aleistercrowleybeast666/SwiftTrust/Models/HARDWARE_REVIEW_v0.1.md

> 历史评审记录：本文中的旧ADC、时钟及引脚假设已由[2026-10-29双板硬件契约](REFERENCE_APPLICATION.md)替代；当前测试/交付见[R8硬件适配报告](R8_HARDWARE_ADAPTATION_20261029.md)。历史结果不代表当前固件或实板验证。

> 历史阶段记录。当前OLED/菜单/协议/实现状态以../HANDOFF.md、OLED_REFERENCE.md和../PROTOCOLS.md为准。

# SwiftThrust v0.1：画板前选型核查

状态：2026-10-19，候选设计，未绑定硬件。最新要求优先核查选型与 CubeMX，采集业务实现暂停。下列“匹配”只表示资源及已知条件匹配，不代表整机电路验证通过。

## MCU 与封装

| 用途 | 精确型号 | 已核对资源 | 结论 |
|---|---|---|---|
| 采集 | STM32F411RCT6 | LQFP64 10×10 mm；256 KiB Flash、128 KiB SRAM，最高100 MHz；有SDIO与SPI、DMA1/2 | 支持单卡SDIO四位与两条SPI候选分工；不是512 KiB Flash型号 |
| 遥控 | STM32G071KBT6 | **不带N的GP版本**，LQFP32 7×7 mm；128 KiB Flash、32 KiB带校验/36 KiB无校验SRAM，按32 KiB预算，最高64 MHz；SPI/I2C/TIM/ADC、DMA+DMAMUX | 当前功能资源匹配；没有SDIO，遥控端也不承担TF记录 |

依据：[ST F411精确料号](https://estore.st.com/en/stm32f411rct6-cpn.html)、[F411 DS10314 Rev8](https://www.st.com/resource/en/datasheet/stm32f411ce.pdf)、[G071精确料号](https://estore.st.com/en/stm32g071kbt6-cpn.html)、[G071 DS12232 Rev5，图5及订货信息](https://www.st.com/resource/en/datasheet/stm32g071kb.pdf)。并逐脚读取本机CubeMX官方器件XML交叉核对。

G071KBT6N也为LQFP32，但pin17的PB2变为PB15，pin26–29的PA15/PB3/PB4/PB5变为PD0/PD1/PD2/PD3。当前无线候选使用PA15、PB3–PB5，**不能替换为N版本**。BOM、原理图符号和采购完整料号必须一致。G071该32脚封装的电源是VDD/VDDA与VSS/VSSA共脚，不应凭大封装符号添加独立VBAT/VREF+脚；PF2-NRST、SWD和BOOT选项留原样，不操作选项字节。F411RCT6仅有VCAP1（pin30），不要套用其它F4的双VCAP符号；PB11未引出，不可分配。

## ADS131M02 与桥式传感器

ADS131M02IPWR为TSSOP-20候选。用户界面的“CH1推力”对应器件**CH0/AIN0P/N**，“CH2激励监测”对应器件CH1/AIN1P/N，避免编号错位。

高增益输入核查：芯片正常AVDD为2.7–3.6 V；2.5 V只是桥激励候选，**不能当作ADC模拟供电**。每个模拟输入在增益≥8时需满足 `AGND−1.3 V ≤ AIN ≤ AVDD−1.8 V`，增益≤4时上限为AVDD；同时差分幅度不得超过`±1.2 V/PGA`。这些是推荐工作范围，不是绝对最大额定值。

2.5 V对地桥激励且桥对称时，两个信号端约1.25 V共模。AVDD=3.0 V、高增益时输入上限只有1.2 V，**不匹配**；若稳定AVDD=3.3 V，则标称上限1.5 V，但必须以最低AVDD、激励误差、桥偏置、温漂、信号峰值和噪声再算余量。不能只凭“差分只有几mV”认定可用。

令传感器灵敏度为S mV/V，激励为E V，则额定信号为`S×E mV`；PGA须覆盖零偏、额定载荷、允许过载与标定方向，预留余量。示例仅说明公式：S=2、E=2.5时为5 mV，PGA128的差分满量程为9.375 mV，是否足够仍取决于真实传感器。尚未选择PGA或承诺有效分辨率；需检查输入阻抗对桥输出阻抗的负载误差、匹配RC、源阻抗、ESD/限流漏电以及低频漂移。差分ADC的24位输出不等于24位整机有效精度。

四线接口只含EXC±、SIG±；六线另有SENSE±。六线的远端激励补偿需实际布设高阻差分sense测量及/或稳压反馈，不能只换六针插座。四线可按电路明确在板端连接本地sense，但不能声称消除了电缆压降。ADC采用内部参考，没有可直接接桥激励的外部参考引脚；若CH2用于远端激励，软件比值换算仍需同步通道、各自PGA、分压比和标定，不能称硬件天然比率测量。

CH2不能将2.5 V直接相对地输入：PGA1差分满量程仅1.2 V。候选为独立低增益与差分衰减网络；最大分压比要满足`k×Emax < 1.2/PGA`并留裕量，同时逐端满足共模范围。电阻值、PGA、滤波/缓冲、sense接法、输入保护与四/六线切换方式尚未定。不要把远端SENSE−未经分析直接当作板上AGND。

以上条件来自[TI ADS131M02 SBAS853A RevA，6.3、8.3、8.5](https://www.ti.com/lit/ds/symlink/ads131m02.pdf)，数值例子是本项目推算。

## 数字接口与采样时基

ADC默认24位字长的常规NULL连续采样帧为4字：状态/前帧命令响应、CH0、CH1、输出CRC，共96 bit/12 byte。CRC覆盖前9字节；16位CRC位于末字最高16位，末字节填零。默认CCITT多项式0x1021，初值0xFFFF；另有ANSI配置，不能混用。状态原值应记录并检查RESET、F_RESYNC、REG_MAP、CRC_ERR、CRC_TYPE、WLENGTH及两路DRDY。16/32位字长和多寄存器命令不属于此12字节解析格式。

SPI为mode1（CPOL0/CPHA1）；CS覆盖完整帧。正常采样需要持续外部CLKIN，不能依赖仅用于特殊检测模式的内部振荡。`fMOD=fCLKIN/2`，普通连续转换时`fSPS=fCLKIN/(2×OSR)`，还必须匹配功耗模式与滤波配置。8.192 MHz/HR/OSR2048得到标称2kSPS是候选示例，未选振荡器或将此写成硬件配置。若MCU产生时钟，要验证可整除频率、占空比、抖动、启停与上电时序；PA8仅预留此选项，未启用MCO。上电或暂停后须按手册处理内部两深度FIFO和滤波稳定，不能把旧样本当新样本。

DRDY边沿捕获单调硬件时间并维护序号；DMA忙/队列满仍计数。扩展32位timer时须处理回绕及读取竞态；日志时间是DRDY参考时刻，不是模拟信号零延迟时刻，应记录滤波延迟。外部ADC无样本序号，长时间屏蔽中断会漏边沿，需同时检查时间间隔与ADC状态，不能承诺仅靠软件序号精确发现所有丢样。采样率要由CLKIN/OSR及实测连续时间戳核实，不能把任务延时或TF写入频率当作采样率。

[TI参考设计TIDUF72的采样与CRC实现说明](https://www.ti.com/lit/pdf/tiduf72)交叉支持12字节帧/9字节CRC覆盖。数字供电DVDD=3.3 V时ADC与3.3 V MCU逻辑兼容；不能把CAP数字LDO节点错误并接到3.3 V，更不能把5 V电平接入。

## E28与供电

亿佰特官方[E28-2G4M12XX英文手册，§2–4](https://www.cdebyte.com/pdf-down.aspx?id=2994)已在内存读取核对：SX1281 SPI模组，SX版本17.8×15 mm、IPEX；工作供电1.8–3.6 V、标称3.3 V，3.3 V通信电平；SPI最高10 Mbit/s。按手册预留MISO/MOSI/SCK/NSS、NRESET、BUSY和DIO1；DIO2/3不默认占用MCU管脚。NRESET低有效。当前候选IRQ使用DIO1，需后续驱动明确映射。

手册TX电流约45 mA为规划依据，不是整机最大电流。3.3 V电源要叠加TF写入峰值、MCU、ADC、OLED和桥激励负载；桥耗电约`E/Rbridge`，电阻值未给。射频模组远离ADC、时钟和开关节点，电源就近去耦，天线按所用IPEX方案及天线要求布置。旧2473MHz/+12dBm/SF10/BW812k/CR4/5与用户实测600/660m只存为历史；SF11/BW406k仍是候选，不写入默认发射配置，不宣称距离。

按常见4.2 V满充单锂方案推算，电池不能直供最大3.6 V的MCU/ADC/E28。仅3.3 V LDO或降压无法覆盖电池放电到低于稳压余量的全过程；是否升降压、何时欠压停止、模拟净化与功耗预算，要依据电芯和允许运行范围选择。2.5 V桥激励还需独立评估噪声、负载、启动和稳定度，不能凭稳压标称值定案。

充电输入、系统电源、电池、SWD调试供电、TF及传感器外来电源之间需核对反灌、电源关闭后的IO注入、掉电顺序和负载共享。充电器是否有power-path/反向阻断，必须看最终型号，不能从“带充电”推断具备。参考[TI单电池双电源应用SDAA050](https://www.ti.com/lit/pdf/sdaa050)讨论的路径与反向电流问题；本项目未选该文中的芯片。电芯保护、充电终止/温度、连接器额定能力和稳压热耗也待电路确认。

## 画板交接

优先保持ADC模拟信号与桥接口靠近，ADC数字接口朝向MCU；TF靠近PC8–PC12/PD2，无线靠近SPI2管脚。不要为了“分区”割断高速信号连续回流面；模拟低噪声供电与回流布局需随板层和器件布局审查。常规被动件优先现成0805封装，但ADC、MCU、TF座、IPEX和连接器按精确厂家封装，不能一概套0805。ERC要查每个电源/地/去耦、VCAP1、BOOT/NRST、SWD、SDIO上拉/电压、SPI电平、独立EXTI线和DMA复用。

板形、层数、充电/稳压芯片、激励电路、传感器规格、分压/保护和连接器待定。预留的点火PH2.0及未焊端子只记录需求；MOS/执行级/物理解除武装未定，不用GPIO下拉代替它们。本轮未配置点火管脚、驱动或命令。

补充核对：具体共模公式/页码、已收敛模拟供电候选、真实时钟状态、全速率缓冲预算和SDK体积见[FOLLOWUP_REVIEW_v0.1.md](FOLLOWUP_REVIEW_v0.1.md)。
