aleistercrowleybeast666/SwiftTrust/PROTOCOLS.md

# SwiftThrust R8 日志与无线协议入口

无线的完整帧格式、身份、会话、事务、菜单及全部收发流程见 [R8协议](Models/LORA_PROTOCOL_R8.md)。R7旧无线格式不再接收，必须两端同时升级。原NV分区与STLOG001布局保留。

## 2. TF日志：STLOG001

### 2.1 文件组成与CRC

文件为`512B头 + N×32B样本 + 32B结束记录`，干净停止后执行sync和close。文件头一次写入，不在结束时回写。

文件头和每条记录各用CRC32/IEEE：反射多项式0xEDB88320、init=0xFFFFFFFF、xorout=0xFFFFFFFF。校验值自身按小端存储；测试向量ASCII `123456789`结果为0xCBF43926。

### 2.2 512B文件头

| 偏移 | 长度 | 类型 | 内容及单位 |
|---:|---:|---|---|
| 0 | 8 | ASCII | `STLOG001`，含格式版本标识 |
| 8 | 2 | u16 | 文件头长度，固定512B |
| 10 | 2 | u16 | 记录长度，固定32B |
| 12 | 4 | u32 | ADC CLKIN配置频率，Hz |
| 16 | 4 | u32 | 历史ADC的OSR；ADS1220不适用，写0并使用ADC1扩展 |
| 20 | 4 | u32 | 理论有效采样率mHz；ADS1220当前为1976834，区别于标称2000000 |
| 24 | 4 | u32 | boot_epoch，启动代号；**不是Unix时间** |
| 28 | 4 | u32 | 标定profile_id，0表示未指定 |
| 32 | 4 | u32 | 标定profile_version |
| 36 | 4 | i32 | 推力通道零点原始码，count |
| 40 | 8 | i64 | 推力换算斜率，nN/count |
| 48 | 8 | i64 | 历史监测通道换算斜率nV/count；ADS1220无第二通道，固定0 |
| 56 | 1 | u8 | 芯片CH0 PGA倍数，例如1/2/4…128 |
| 57 | 1 | u8 | 历史CH1 PGA倍数；ADS1220固定0，表示不存在 |
| 58 | 1 | u8 | 传感器线数，已标定时应为4或6，未指定可0 |
| 59 | 1 | 位标志 | bit0：标定有效；bit1：合成测试数据；其余保留0 |
| 60 | 24 | 兼容扩展 | 无会话置零时为0；有效时SZR1@60、永久zero:i32@64、会话zero:i32@68、samples:u32@72、time_us:u64@76 |
| 84 | 44 | 兼容扩展 | ADC1元数据，见下表；历史ADS131M02日志为全0 |
| 128 | 380 | 保留 | 固定0 |
| 508 | 4 | u32 | 头CRC32，覆盖偏移0…507 |

| 偏移 | 类型 | ADC1内容 |
|---:|---|---|
| 84 / 88 / 90 | ASCII4 / u16 / u16 | `ADC1` / 版本1 / 扩展长度44 |
| 92 / 94 / 95 | u16 / u8 / u8 | ADC型号1220 / 通道数1 / 原始位数24 |
| 96 / 100 | u32 / u32 | 参考电压µV=5000000 / 标称速率mHz=2000000 |
| 104 / 108 | u32 / u32 | 连续转换周期2072个CLK / START前实测DRDY速率mHz；未测为0 |
| 112 / 113 / 114 | u8 / u8 / u8 | MUX=3(AIN1-AIN2) / Turbo模式=2 / PGA bypass=0或1 |
| 115 / 116 / 117 | u8 / u8 / u8 | 正输入AIN1 / 负输入AIN2 / 1=有符号二进制补码 |
| 118 / 119 | u8 / u8 | 0=无硬件状态字 / 保留0 |
| 120 / 124 | u32 / u32 | 激励标称µV=5000000 / bit0时钟已核对、bit1实测速率有效 |

4.096MHz外部CLK下，Turbo DR=110连续转换周期为2072CLK，即505.859375µs、1976.8339768SPS；首转换另有114CLK启动延迟。依据[TI ADS1220数据手册表8-4](https://www.ti.com/lit/ds/symlink/ads1220.pdf)。头中的实测速率来自DRDY时间戳统计，不是写卡速率；导出报告另外计算保存记录速率、有效记录速率及序号/时间戳推算的转换速率（含估计缺失转换数，不等于实际中断边沿计数）。输入范围和灵敏度完整配置保存在SENSOR.CFG并通过config_id绑定标定，激励/参考字段是配置标称值，未宣称实测。

### 2.3 每条样本32B

| 偏移 | 长度 | 类型 | 内容及单位 |
|---:|---:|---|---|
| 0 | 4 | u32 | DRDY序号；源序号在DMA忙/丢样时也应前进 |
| 4 | 8 | u64 | DRDY边沿单调时间，µs；不是写卡/无线完成时间 |
| 12 | 4 | i32 | 原始CH0码，24位符号扩展，count |
| 16 | 4 | i32 | 历史原始CH1；ADC1单通道日志固定INT32_MIN，明确表示不存在，不是第二路零读数 |
| 20 | 2 | u16 | 历史ADS131M02状态字；ADS1220无状态字，固定0，导出为空 |
| 22 | 2 | 位标志 | 样本质量flags，见下表 |
| 24 | 4 | u32 | 此样本前检测到的缺样数量；无法有序判断时0xFFFFFFFF |
| 28 | 4 | u32 | 记录CRC32，覆盖本条偏移0…27 |

| flags位 | 含义 |
|---:|---|
| 0 | 历史ADC输出CRC错误；ADS1220不产生此标志 |
| 1 | 捕获缓冲补位格式错误；ADS1220只有3B原始码，其余缓冲字节须0 |
| 2 | 历史ADC状态故障；ADS1220传输错误由源错误统计及停止流程报告 |
| 3 | 原始通道达到24位正/负极值，疑似饱和 |
| 4 | 序号不连续 |
| 5 | 时间戳未严格递增 |
| 6…14 | 当前保留0 |
| 15 | 结束记录标识；普通样本为0 |

时间轴使用独立TIM5微秒时钟，尚未实现UTC同步。原始码范围-8388608…8388607。ADS1220没有SPI输出CRC，文件CRC仅验证落盘内容完整性，不能检测所有SPI线上位翻转或证明传感器接线正常。DMA失败/超时不生成虚构样本；源序号间隙及结束错误统计保留丢样事实。

### 2.4 标定与CSV

标定有效时：`force_N = (raw_CH0 - zero_raw) × slope_nN_per_count / 10^9`。

ADS1220输入差分电压为`raw_CH0 × reference_uv / (8388608 × PGA_gain × 10^6)`伏；采用5V同源激励/参考实现比例式测量。没有有效标定时仅提供原始码与电压，推力列为空。历史双通道日志仍按原元数据导出CH1；新日志CH1列为空。

当前CSV导出只有在profile/版本/线数/系数和标定有效标志完整，且样本flags的bit0…3均为0时才给出推力N；未知或故障时留空。监测比例为0时监测V留空。缺样/时间标志仍随行输出。电压档位不是精确SOC。

### 2.5 结束记录与损坏恢复

最后一条的flags固定0x8000；偏移0/4为最后样本序号/时间，偏移12改作**u32环形队列丢弃总数**，偏移16改作**u32 ADC完整性及源DMA错误总数**，其余保留0，仍有同样的CRC32。无样本时序号/时间可0，不能据此当作已有有效采样。

导出工具先验头CRC，再按顺序验记录CRC；遇到坏记录即停止并报告问题，断尾保留完整前缀。完整尾记录且没有多余或坏字节时报告clean_close。sync成功与写入完成分开记录，但这不能保证SD卡内部缓存和FAT目录突然断电绝对安全。

命令：`python -B Models/export_stlog.py input.BIN output.csv`。CSV排他新建，已有同名文件不覆盖。它是通用CSV，**尚未验证UNDERLINE专用导入兼容**。

## 无线实现

唯一R8基础编解码位于 `Acquisition/src/st_frame.c`，会话和普通事务位于 `st_link2.c`；输出策略复用该基础帧和事务ID，保留独立准入、限时授权、一次发送及结果查询。

R1参考格式的 `st_protocol.c` 只用于旧Host兼容回归，ReferenceApp接收路径仅接受R8。

旧R7无线规范见 [历史资料](Models/LORA_PROTOCOL.md)，不适用于当前固件。
