aleistercrowleybeast666/SwiftTrust/STATUS_v0.1.md

# 当前状态索引

文件名沿用初期名称；最新软件、两端组件链接及未完成板级事项请见[HANDOFF](HANDOFF.md)、[协议](PROTOCOLS.md)、[验证说明](Models/VALIDATION.md)。旧阶段报告均为历史证据，不代表整板已验收。
