aleistercrowleybeast666/SwiftTrust/Models/STLOG_FORMAT.md

# STLOG001日志格式

规范已整合至项目根目录 [PROTOCOLS.md](../PROTOCOLS.md)，以该统一文档为准。本文件仅保留旧链接入口，不维护重复字段表。
