aleistercrowleybeast666/SwiftTrust/Models/ignition_ui_preview.png

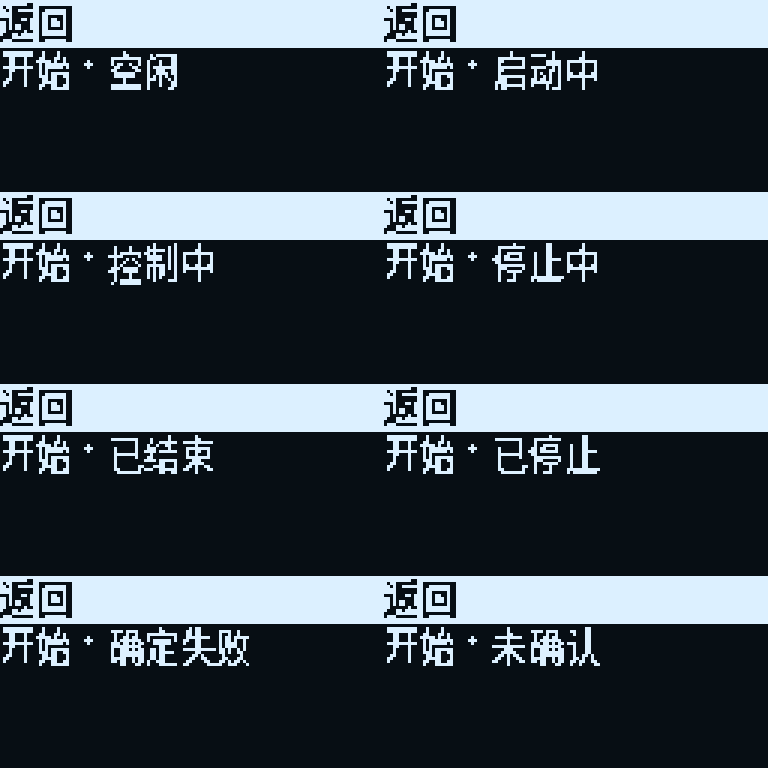
Models/ignition_ui_preview.png
