aleistercrowleybeast666/SwiftTrust/Models/ignition_ui_preview_en.png

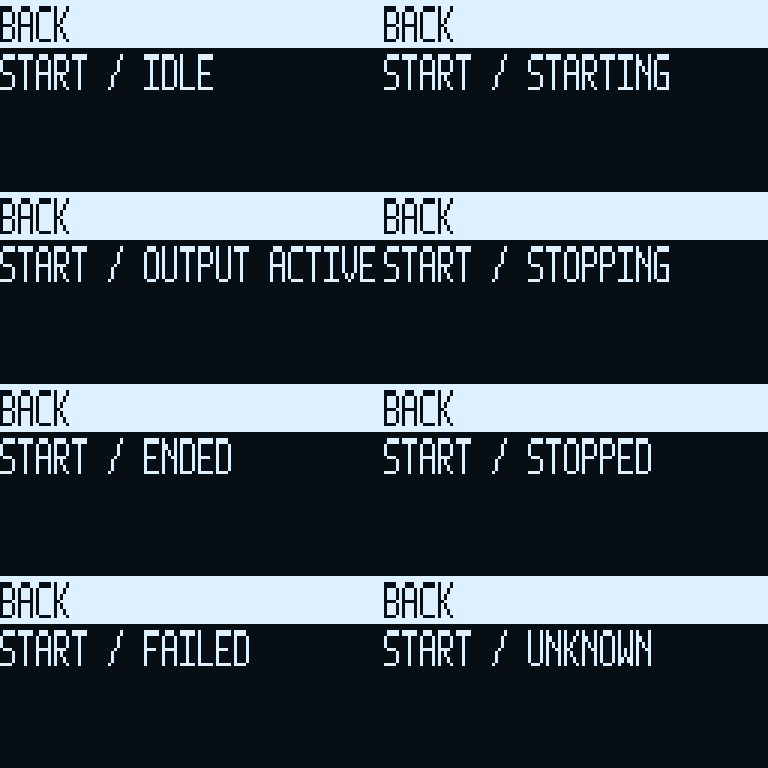
Models/ignition_ui_preview_en.png
