aleistercrowleybeast666/SwiftTrust/Models/ui_host_preview.png

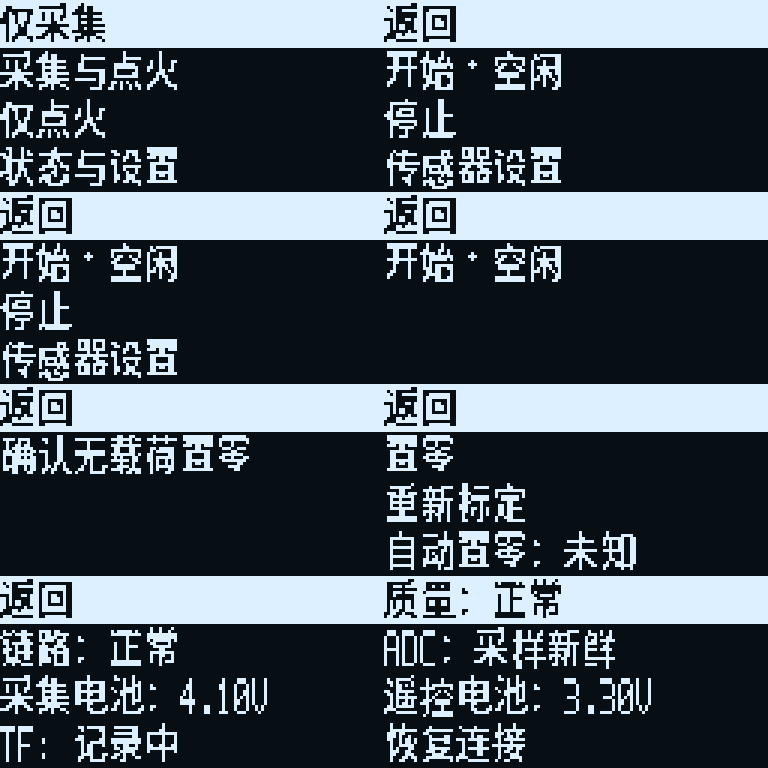
Models/ui_host_preview.png
