aleistercrowleybeast666/SwiftTrust/Models/ui_host_preview_en.png

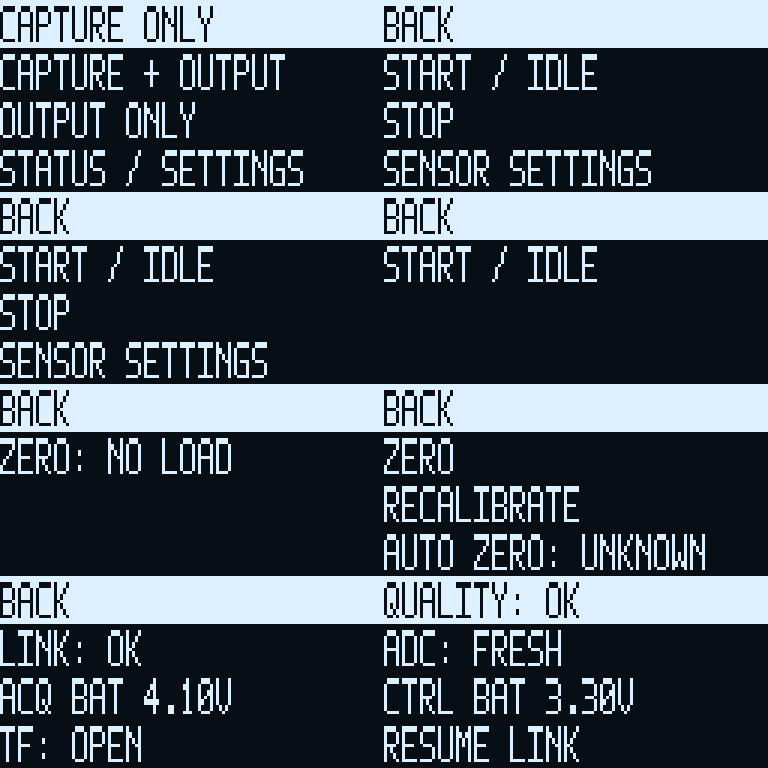
Models/ui_host_preview_en.png
