aleistercrowleybeast666/SwiftTrust/Models/CALIBRATION.md

# R8 ADS1220标定与兼容策略

当前可运行入口为两端ReferenceApp。采集板使用ADS1220，只有AIN1-AIN2一路差分桥式输入，外部参考与桥激励均为标称5V。旧ADS131M02标定不能用于当前ADC；没有有效传感器配置或标定时仍允许记录真实原始码，推力保持无效。

## 传感器配置

TF根目录SENSOR.CFG沿用显式ACK、PROFILE_ID、SENSOR_ID、WIRE_COUNT、RATED_FORCE_MN、EXCITATION_UV、MAX_SPAN_COUNTS、MIN_DELTA_COUNTS及可选AUTO_ZERO。新增必填PGA_GAIN、PGA_BYPASS、SENSITIVITY_NV_V、COMMON_MODE_MIN_UV、COMMON_MODE_MAX_UV。2mV/V填写2000000nV/V；满量程输入µV=激励µV×灵敏度nV/V÷10^9，向上取整后检验PGA满量程及输入共模限制。

ADC初始化采用经检查的配置。PGA只能1/2/4/8/16/32/64/128，bypass仅允许1/2/4。启用PGA时按TI共模/输出摆幅限制检查整个声明输入范围；不接受任意传感器默认PGA128。未知传感器采用PGA1、bypass的原始记录配置，不代表已经验证传感器兼容性。例文件的零值故意使标定无效，必须按真实传感器填写。

配置绑定包含ADC型号、外部参考、输入MUX、PGA与bypass、Turbo模式、ADC时钟、理论有效速率、激励、传感器ID、额定力、线数及配置指纹。指纹按规范整数值生成，包含灵敏度、共模范围及稳定阈值；不因文件空白或临时AUTO_ZERO改变。未知、重复、缺失、溢出和错误字段拒绝配置。

## 原始码与力值

ADS1220输入电压`Vdiff = raw × 5 / (8388608 × PGA)`伏。AIN1为正输入，AIN2为负输入；允许通过已知载荷标定得到负斜率，不能强行翻转原始码。外部参考和桥激励同源，标称值不冒充实时电压测量。

永久空载均值r0和加载均值r1只由只读原始窗口统计；`k=round(Fref_nN/(r1-r0))`，以有符号nN/count保存。推力为`(raw-r0)×k/10^9`N，窗口过程从不修改原始码或日志记录。参考质量以显式g/kg及保存的重力换算，N直接输入。0系数、越界参考力、饱和、SPI/源错误、队列溢出、缺样、非递增时间、噪声超限和超时拒绝候选。

## 菜单与会话置零

保留四行菜单、旋转选择、短按确认、载荷编辑、审阅、保存和取消。永久空载和加载窗口完成后，只有SAVE完成真实文件sync、close及逐字节读回才替换活动参数；无线接收ACK不等于保存完成。SAVE回复丢失显示结果未确认，通过后续查询核对，不谎报旧值必定保留。

本次会话置零保持独立，默认关闭、可配置自动置零。它使用稳定窗口覆盖本次日志的零点，保留永久零点和斜率；SZR1扩展同时记录永久零点、会话零点、样本数及时间。重新开始且关闭会话置零时恢复永久零点。运行中不更改标定。

## CAL0.BIN / CAL1.BIN迁移

两个固定1KiB文件保留STCS0001/STCC0001封装、64位代号、CRC、256B STCAL001和提交封记。新STCAL001仅在原保留区域增加ADC1扩展：176处magic、180处u16型号1220、182处MUX、183处bypass、184处u32参考µV、188处u32扩展版本1；192..251仍为0，252处CRC32。历史全零扩展可解析为旧ADS131M02，不能与新绑定相等。

检测到完整有效但绑定不同的ADC/传感器/增益文件，且其代号高于任何匹配文件时返回ST_CAL_DISK_MIGRATION，活动标定无效、原始采集仍可用，并允许用户完成新标定。新SAVE写入另一个槽，代号高于最高旧代号，revision从1开始，按数据→sync→封记→sync→close→重新打开读回的原流程提交；最高代号旧文件在新提交前不被覆盖。重启后优先选择更高代号、绑定匹配的新文件。相同代号冲突仍报故障。不同传感器/PGA配置不自动应用、也不自动覆盖；仅明确完成的新标定可保存。较新异绑定文件存在时不会回退使用较旧匹配系数。不擦除配对NV、不重置会话序号。

已损坏新槽与有效旧槽共存时仍可重新完成迁移。两槽均损坏或发生I/O错误时保留明确故障，不格式化。FAT元数据、卡FTL与掉电不由双文件机制绝对保证；需实物断电测试。

## 调度与验证边界

DRDY/DMA中断只投递带时间戳的原始码及错误，标定计算和FatFs位于唯一前台owner。标定tap为64项独立队列，队列溢出和DMA错误拒绝候选。日志仍为512B头、32B记录；ADC1元数据及旧日志读取见[日志规范](../PROTOCOLS.md)。

离线回归覆盖正负标定、原始码不变、ADC配置/参考绑定失配、旧格式解析但不应用、迁移后新系数保存/读回、双槽每扇区错误/撕裂、取消、会话置零、R8重试和菜单。实际加载/卸载、多点线性、噪声、共模、电源比例误差及动态响应仍须实物验证，主机模拟不代表已完成校准。
