aleistercrowleybeast666/SwiftTrust/Models/calibration_ui_preview.png

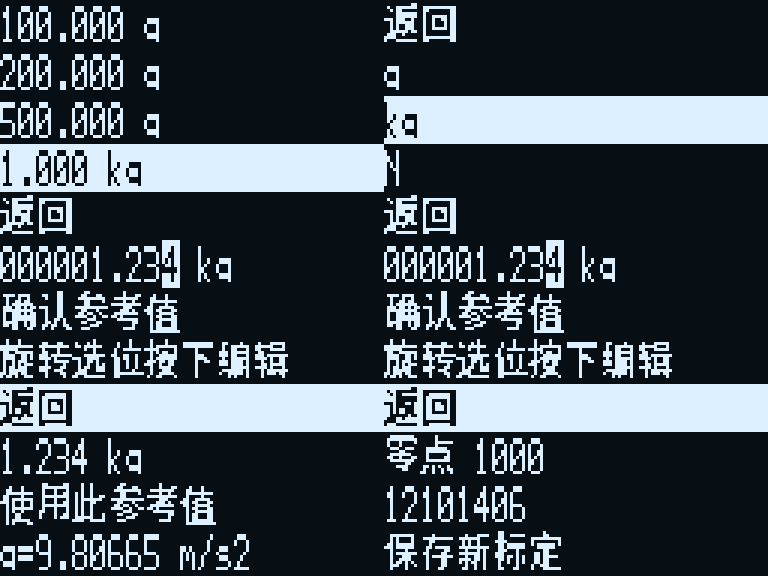
Models/calibration_ui_preview.png
