aleistercrowleybeast666/SwiftTrust/Models/calibration_ui_preview_en.png

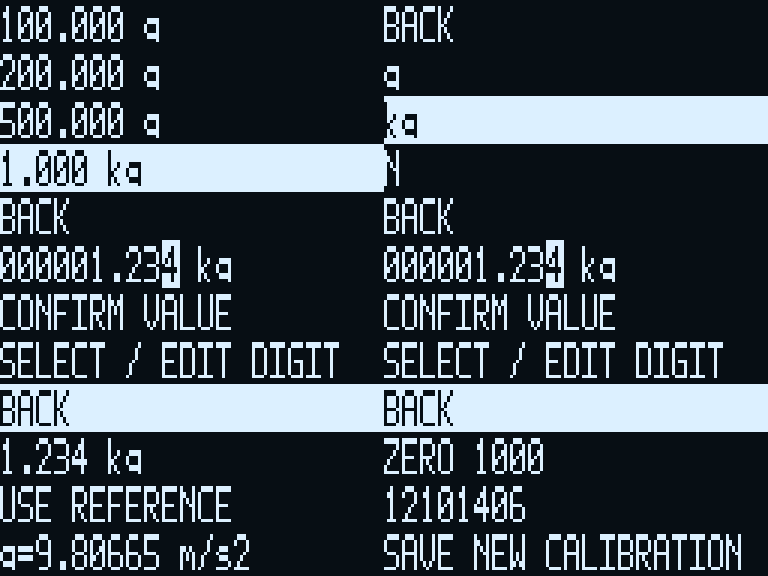
Models/calibration_ui_preview_en.png
