aleistercrowleybeast666/SwiftTrust/Acquisition/SwiftThrust_Acquisition_Candidate/SwiftThrust_Acquisition_Candidate.ioc

Mcu.UserName=STM32F411RCTx
PA0-WKUP.GPIO_Label=CAND_IGNITION_SIGNAL
PA0-WKUP.Signal=S_TIM2_CH1_ETR
PA13.GPIO_Label=CAND_SWDIO
PA13.Signal=SYS_JTMS-SWDIO
PA14.GPIO_Label=CAND_SWCLK
PA14.Signal=SYS_JTCK-SWCLK
PA15.GPIO_Label=CAND_ADC_DRDY
PA15.Signal=GPXTI15
PA2.GPIO_Label=CAND_DEBUG_UART_TX
PA2.Signal=USART2_TX
PA3.GPIO_Label=CAND_DEBUG_UART_RX
PA3.Signal=USART2_RX
PA4.GPIO_Label=CAND_LED_VOLT_1
PA4.Signal=GPIO_Output
PA5.GPIO_Label=CAND_LED_VOLT_2
PA5.Signal=GPIO_Output
PA6.GPIO_Label=CAND_LED_VOLT_3
PA6.Signal=GPIO_Output
PA7.GPIO_Label=CAND_LED_VOLT_4
PA7.Signal=GPIO_Output
PA8.GPIO_Label=CAND_ADC_CLK
PA8.Signal=RCC_MCO_1
PA9.GPIO_Label=CAND_TF_CARD_DETECT
PA9.Signal=GPIO_Input
PB10.GPIO_Label=CAND_LINK_LED
PB10.Signal=GPIO_Output
PB12.GPIO_Label=CAND_RADIO_CS
PB12.Signal=GPIO_Output
PB13.GPIO_Label=CAND_RADIO_SCK
PB13.Signal=SPI2_SCK
PB14.GPIO_Label=CAND_RADIO_MISO
PB14.Signal=SPI2_MISO
PB15.GPIO_Label=CAND_RADIO_MOSI
PB15.Signal=SPI2_MOSI
PB2.GPIO_Label=CAND_RADIO_NRESET
PB2.Signal=GPIO_Output
PB3.GPIO_Label=CAND_ADC_SCK
PB3.Signal=SPI1_SCK
PB4.GPIO_Label=CAND_ADC_DOUT
PB4.Signal=SPI1_MISO
PB5.GPIO_Label=CAND_ADC_DIN
PB5.Signal=SPI1_MOSI
PB6.GPIO_Label=CAND_ADC_CS
PB6.Signal=GPIO_Output
PC0.GPIO_Label=CAND_ACQUISITION_BATTERY
PC0.Signal=ADCx_IN10
PC10.GPIO_Label=CAND_TF_D2
PC10.Signal=SDIO_D2
PC11.GPIO_Label=CAND_TF_D3
PC11.Signal=SDIO_D3
PC12.GPIO_Label=CAND_TF_CLK
PC12.Signal=SDIO_CK
PC6.GPIO_Label=CAND_RADIO_BUSY
PC6.Signal=GPIO_Input
PC7.GPIO_Label=CAND_RADIO_DIO1
PC7.Signal=GPXTI7
PC8.GPIO_Label=CAND_TF_D0
PC8.Signal=SDIO_D0
PC9.GPIO_Label=CAND_TF_D1
PC9.Signal=SDIO_D1
PD2.GPIO_Label=CAND_TF_CMD
PD2.Signal=SDIO_CMD
