aleistercrowleybeast666/SwiftTrust/Models/validate_candidates.py

"""Offline resource/analog math regression. Not a firmware, timing or hardware test."""
import csv
import os
import io
import json
import re
import subprocess
import sys
import unittest
from unittest.mock import patch
import xml.etree.ElementTree as ET
from pathlib import Path

ROOT = Path(__file__).resolve().parents[1]
DB = Path(os.environ.get("CUBEMX_ROOT",r"C:\Program Files\STMicroelectronics\STM32Cube\STM32CubeMX"))/"db/mcu"
NS = {"m": "http://mcd.rou.st.com/modules.php?name=mcu"}
PARTS = {
    "Acquisition": ("STM32F411RCT6", "STM32F411R(C-E)Tx.xml", "LQFP64"),
    "Controller": ("STM32G071KBT6", "STM32G071K(6-8-B)Tx.xml", "LQFP32"),
}
ACQUISITION_PIN_ASSIGNMENT = {
    "ADC_SCK": ("PB3", "55", "SPI1_SCK"),
    "ADC_DOUT": ("PB4", "56", "SPI1_MISO"),
    "ADC_DIN": ("PB5", "57", "SPI1_MOSI"),
    "ADC_CS": ("PB6", "58", "GPIO_Output"),
    "ADC_DRDY": ("PA15", "50", "GPIO_EXTI15"),
    "LED_VOLT_1": ("PA4", "20", "GPIO_Output"),
    "LED_VOLT_2": ("PA5", "21", "GPIO_Output"),
    "LED_VOLT_3": ("PA6", "22", "GPIO_Output"),
    "LED_VOLT_4": ("PA7", "23", "GPIO_Output"),
    "TF_CARD_DETECT": ("PA9", "42", "GPIO_Input"),
    "DEBUG_UART_TX": ("PA2", "16", "USART2_TX"),
    "DEBUG_UART_RX": ("PA3", "17", "USART2_RX"),
}


def read_csv(path):
    with path.open(encoding="utf-8", newline="") as handle:
        return list(csv.DictReader(handle))


def pin_db(filename):
    root = ET.parse(DB / filename).getroot()
    return {p.get("Name"): (p.get("Position"), {s.get("Name") for s in p.findall("m:Signal", NS)})
            for p in root.findall("m:Pin", NS)}


def gpio_af_db(filename="GPIO-STM32F411_gpio_v1_0_Modes.xml"):
    root = ET.parse(DB / "IP" / filename).getroot()
    return {(pin.get("Name"), signal.get("Name")): {
                value.text for value in signal.findall(
                    "m:SpecificParameter[@Name='GPIO_AF']/m:PossibleValue", NS)}
            for pin in root.findall("m:GPIO_Pin", NS)
            for signal in pin.findall("m:PinSignal", NS)}


def usart_async_defaults():
    # CubeMX omits parameters set to their defaults when saving the IOC.
    root = ET.parse(DB / "IP/USART-sci2_v1_2_Cube_Modes.xml").getroot()
    fields = {"BaudRate", "WordLength", "StopBits", "Parity"}
    return {param.get("Name"): param.get("DefaultValue")
            for param in root.findall("m:RefParameter", NS)
            if param.get("Name") in fields and param.find("m:Condition", NS) is None}


def validate_acquisition_assignment(rows):
    # Explicit user assignment takes precedence over the still-old CAD export.
    by_role = {row["role"]: row for row in rows}
    for role, expected in ACQUISITION_PIN_ASSIGNMENT.items():
        row = by_role.get(role, {})
        actual = tuple(row.get(key) for key in ("pin", "package_position", "signal"))
        if actual != expected:
            raise ValueError("Acquisition 2026-11-01 pin assignment mismatch: " + role)


def validate_pins(rows, pins):
    seen_positions, seen_exti = set(), set()
    for row in rows:
        pin, signal = row["pin"], row["signal"]
        if pin not in pins:
            raise ValueError(f"Pin not present in exact package: {pin}")
        position, signals = pins[pin]
        if str(position) != row["package_position"]:
            raise ValueError(f"Physical pin mismatch: {pin}")
        if position in seen_positions:
            raise ValueError(f"Duplicate physical position: {position}")
        seen_positions.add(position)
        if signal == "RESERVED":
            continue
        if signal.startswith("GPIO_") or signal.startswith("GPXTI"):
            if "GPIO" not in signals:
                raise ValueError(f"GPIO unavailable: {pin}")
        elif signal not in signals:
            raise ValueError(f"Alternate function unavailable: {pin}/{signal}")
        if signal.startswith(("GPXTI", "GPIO_EXTI")):
            exti = int(re.search(r"\d+$", signal).group())
            if int(re.search(r"\d+", pin).group()) != exti or exti in seen_exti:
                raise ValueError("Invalid or conflicting EXTI line")
            seen_exti.add(exti)


def dma_db():
    root = ET.parse(DB / "IP/DMA-STM32F411_dma_v2_0_Modes.xml").getroot()
    streams, channels = {}, {}
    for e in root.iter():
        tag, name = e.tag.split("}")[-1], e.get("Name", "")
        if tag == "Mode" and re.fullmatch(r"DMA[12]_Stream\d", name):
            streams[name] = {m.get("Name") for m in e.iter() if m.tag.split("}")[-1] == "Mode"}
        if tag == "RefMode":
            values = set()
            for param in e:
                if param.get("Name") == "Channel":
                    values.update(p.text for p in param if p.text)
            if values:
                channels[name] = values
    return streams, channels


def validate_dma(rows, mapping):
    streams, channels = mapping
    used = set()
    for row in rows:
        stream = f'{row["controller"]}_Stream{row["stream"]}'
        mode = row["mode_name"]
        if stream in used:
            raise ValueError("Exclusive DMA stream conflict")
        used.add(stream)
        if mode not in streams.get(stream, set()):
            raise ValueError(f"DMA request not mapped: {stream}/{mode}")
        if f'DMA_CHANNEL_{row["channel"]}' not in channels.get(mode, set()):
            raise ValueError(f"Wrong DMA channel: {mode}")


def read_ioc(path):
    # CubeMX writes Java-property escaped spaces in remapped G0 pin keys.
    return {key.replace("\\ ", " "): value for key, value in
            (line.split("=", 1) for line in path.read_text(encoding="utf-8").splitlines()
             if "=" in line and not line.startswith("#"))}


def validate_ioc(board, rows):
    part, _, package = PARTS[board]
    path = ROOT / board / f"SwiftThrust_{board}_Candidate" / f"SwiftThrust_{board}_Candidate.ioc"
    values = read_ioc(path)
    if values.get("Mcu.CPN") != part or values.get("Mcu.Package") != package:
        raise ValueError(f"{board}: wrong exact device or package")
    constants = dict(item.split(",", 1) for item in values.get("Mcu.UserConstants", "").split(";") if "," in item)
    if constants.get("SWIFTTHRUST_BOARD_BOUND") not in ("0", "1"):
        raise ValueError("Board CAD binding annotation missing")
    if board == "Acquisition":
        expected_constants = {"SWIFTTHRUST_ADC_AVDD_MV_CANDIDATE": "5000", "SWIFTTHRUST_ADC_DVDD_MV_CANDIDATE": "3300", "SWIFTTHRUST_BRIDGE_EXC_MV_CANDIDATE": "5000"}
        if any(constants.get(k) != v for k, v in expected_constants.items()):
            raise ValueError("Analog candidate annotations not saved in CubeMX")
    for row in rows:
        signal, pin = row["signal"], row["pin"]
        actual = values.get(f"{pin}.Signal")
        if signal == "RESERVED":
            if actual:
                raise ValueError(f"Reserved pin unexpectedly enabled: {pin}/{actual}")
            continue
        # CubeMX may emit shared ADCx/TIM signals with an explicit SH mapping.
        shared = any(k.startswith(f"SH.{actual}.") and (v == signal or v.startswith(signal + ","))
                     for k, v in values.items()) if actual else False
        if actual != signal and not shared:
            raise ValueError(f"{board}: saved .ioc mismatch {pin}: {actual!r}, expected {signal!r}")
        if signal.startswith("GPIO_EXTI") and not shared:
            raise ValueError("EXTI shared signal is not bound to the actual GPIO interrupt")
        if row["role"] in ("SWDIO", "SWCLK") and values.get(f"{pin}.Mode") != "Serial_Wire":
            raise ValueError("SWD pin is not assigned to Serial_Wire mode")
        if values.get(f"{pin}.GPIO_Label") != "CAND_" + row["role"]:
            raise ValueError(f"{board}: saved pin role label does not match candidate table: {pin}")
        if row["status"] == "idle_high_candidate" and values.get(f"{pin}.PinState") != "GPIO_PIN_SET":
            raise ValueError(f"Candidate CS/reset idle state missing: {pin}")
    if board == "Acquisition":
        validate_acquisition_assignment(rows)
        clock = {
            "HSE_VALUE": "8192000", "PLLM": "8", "PLLN": "375",
            "PLLP": "RCC_PLLP_DIV4", "PLLQ": "8",
            "PLLSourceVirtual": "RCC_PLLSOURCE_HSE",
            "SYSCLKSource": "RCC_SYSCLKSOURCE_PLLCLK",
            "APB1CLKDivider": "RCC_HCLK_DIV2",
            "RCC_MCO1Source": "RCC_MCO1SOURCE_HSE", "RCC_MCODiv1": "RCC_MCODIV_2",
            "SYSCLKFreq_VALUE": "96000000", "APB1Freq_Value": "48000000",
            "APB2Freq_Value": "96000000", "PLLQCLKFreq_Value": "48000000",
            "MCO1PinFreq_Value": "4096000"}
        for key, expected in clock.items():
            if values.get("RCC." + key) != expected:
                raise ValueError("Acquisition IOC clock differs from board contract: " + key)
        if values.get("SPI1.CLKPhase") != "SPI_PHASE_2EDGE":
            raise ValueError("ADS SPI must be mode 1")
        if values.get("SPI1.Mode") != "SPI_MODE_MASTER" or values.get("SPI2.Mode") != "SPI_MODE_MASTER":
            raise ValueError("SPI master configuration missing")
        expected_gpio = {
            "PA15.GPIO_ModeDefaultEXTI": "GPIO_MODE_IT_FALLING",
            "PA9.GPIO_PuPd": "GPIO_PULLUP", "PB6.PinState": "GPIO_PIN_SET",
            "PA4.PinState": "GPIO_PIN_RESET", "PA5.PinState": "GPIO_PIN_RESET",
            "PA6.PinState": "GPIO_PIN_RESET", "PA7.PinState": "GPIO_PIN_RESET",
            "USART2.VirtualMode": "VM_ASYNC"}
        for key, expected in expected_gpio.items():
            if values.get(key) != expected:
                raise ValueError("Acquisition GPIO/UART contract differs: " + key)
        defaults = usart_async_defaults()
        for key, expected in {"BaudRate": "115200", "WordLength": "WORDLENGTH_8B",
                              "StopBits": "STOPBITS_1", "Parity": "PARITY_NONE"}.items():
            if values.get("USART2." + key, defaults.get(key)) != expected:
                raise ValueError("Acquisition USART2 frame differs: " + key)
        for irq, priority in (("EXTI15_10_IRQn", "0"), ("EXTI9_5_IRQn", "4"),
                              ("USART2_IRQn", "14")):
            if values.get("NVIC." + irq, "").split("\\:")[:2] != ["true", priority]:
                raise ValueError("Acquisition IRQ binding missing or wrong priority: " + irq)
        for pin in ("PC4", "PA10", "PB7", "PB8", "PB9"):
            if values.get(pin + ".Signal"):
                raise ValueError("Obsolete acquisition pin assignment is still active: " + pin)
        if any(key.startswith("USART1.") for key in values):
            raise ValueError("Acquisition debug UART must no longer use USART1")
        for pin in ["PC8", "PC9", "PC10", "PC11", "PC12", "PD2"]:
            if values.get(f"{pin}.Mode") != "SD_4_bits_Wide_bus":
                raise ValueError("SDIO four-bit mode missing")
    if board == "Controller":
        by_role = {row["role"]: row for row in rows}
        for role, expected in (("ENCODER_A", ("PA5", "12", "TIM2_CH1")),
                               ("ENCODER_B", ("PA1", "8", "TIM2_CH2"))):
            actual = tuple(by_role.get(role, {}).get(key) for key in
                           ("pin", "package_position", "signal"))
            if actual != expected:
                raise ValueError("Controller 2026-11-08 encoder assignment mismatch: " + role)
        if values.get("PA0.Signal"):
            raise ValueError("Controller encoder must release PA0")
        for key, expected in {"TIM2.EncoderMode": "TIM_ENCODERMODE_TI12",
                              "TIM2.Period": "65535", "TIM2.IC1Filter": "8",
                              "TIM2.IC2Filter": "8", "PA5.GPIO_PuPd": "GPIO_PULLUP",
                              "PA1.GPIO_PuPd": "GPIO_PULLUP"}.items():
            if values.get(key) != expected:
                raise ValueError("Controller encoder configuration differs: " + key)
        for signal in ["TIM2_CH1", "TIM2_CH2"]:
            if not any(v == signal + ",Encoder_Interface" for k, v in values.items() if k.startswith("SH.")):
                raise ValueError("Encoder pins are not assigned to Encoder_Interface")
        for suffix in ("PINREMAP", "PINREMAP_10_12"):
            if values.get(f"VP_SYS_VS_{suffix}.Mode") != suffix:
                raise ValueError("USART1 PA11/PA12 package-pad remap missing")
        if values.get("PA3.Signal") != "ADC1_IN3" or values.get("PA4.Signal"):
            raise ValueError("Controller battery must use PA3, not obsolete PA4")
        # CubeMX 6.15.0 omits these effective defaults on save for this exact
        # HSI16/single-conversion setup. Both Controller CLI scripts query the
        # live values as well; explicit different values must still fail.
        if any(values.get("RCC." + key) != "16000000" for key in
               ("SYSCLKFreq_VALUE", "AHBFreq_Value", "APBFreq_Value")):
            raise ValueError("Controller must retain the 16 MHz clock tree")
        if values.get("ADC1.ClockPrescaler", "ADC_CLOCK_SYNC_PCLK_DIV2") != "ADC_CLOCK_SYNC_PCLK_DIV2":
            raise ValueError("Controller ADC clock must be HSI16/PCLK divided by two")
        if (values.get("ADC1.ScanConvMode", "ADC_SCAN_DISABLE") != "ADC_SCAN_DISABLE"
                or values.get("ADC1.NbrOfConversion", "1") != "1"):
            raise ValueError("Controller ADC must retain single-conversion mode")
        if values.get("ADC1.SamplingTimeCommon1") != "ADC_SAMPLETIME_160CYCLES_5":
            raise ValueError("VREFINT and divided battery need long sampling time")
    return path


def adc_input_fits(avdd, gain, positive, negative, reference=5.0, bypass=False):
    # ADS1220 datasheet section 8.3.2, PGA headroom and differential full scale.
    if (gain not in (1, 2, 4, 8, 16, 32, 64, 128) or not 2.3 <= avdd <= 5.5
            or not 0 < reference <= avdd):
        return False
    differential = abs(positive - negative)
    if differential * gain > reference:
        return False
    if bypass:
        return gain <= 4 and 0 <= positive <= avdd and 0 <= negative <= avdd
    common = (positive + negative) / 2
    headroom = 0.2 + gain * differential / 2
    return max(avdd / 4, headroom) <= common <= avdd - headroom


def ordinary_rate(clock_hz, conversion_cycles):
    # ADS1220 Turbo DR=110, continuous: table8-4 specifies 2072 tCLK.
    # First START incurs114 extra clocks; timestamps establish real DRDY rate.
    if clock_hz is None or conversion_cycles is None:
        return None
    return clock_hz / conversion_cycles


class Regression(unittest.TestCase):
    def test_all_exact_package_pins(self):
        for board, (_, filename, _) in PARTS.items():
            validate_pins(read_csv(ROOT / board / "pin_candidates.csv"), pin_db(filename))

    def test_gp_pinout_rejects_n_substitution(self):
        rows = read_csv(ROOT / "Controller/pin_candidates.csv")
        with self.assertRaises(ValueError):
            validate_pins(rows, pin_db("STM32G071K(8-B)TxN.xml"))

    def test_duplicate_physical_pin_rejected(self):
        rows = read_csv(ROOT / "Acquisition/pin_candidates.csv")
        with self.assertRaises(ValueError):
            validate_pins(rows + [rows[0]], pin_db(PARTS["Acquisition"][1]))

    def test_invalid_alternate_function_rejected(self):
        rows = read_csv(ROOT / "Acquisition/pin_candidates.csv")
        rows[0]["signal"] = "SPI2_SCK"
        with self.assertRaises(ValueError):
            validate_pins(rows, pin_db(PARTS["Acquisition"][1]))

    def test_same_exti_line_on_different_ports_rejected(self):
        rows = read_csv(ROOT / "Acquisition/pin_candidates.csv")
        rows.append(dict(pin="PC15-OSC32_OUT", package_position="4", signal="GPXTI15"))
        with self.assertRaisesRegex(ValueError, "conflicting EXTI"):
            validate_pins(rows, pin_db(PARTS["Acquisition"][1]))

    def test_acquisition_new_pin_assignment_and_official_af_numbers(self):
        validate_acquisition_assignment(read_csv(ROOT / "Acquisition/pin_candidates.csv"))
        validate_acquisition_assignment([row for row in read_csv(ROOT / "Models/reference_pins.csv")
                                          if row["board"] == "Acquisition"])
        afs = gpio_af_db()
        for pin, signal in (("PB3", "SPI1_SCK"), ("PB4", "SPI1_MISO"), ("PB5", "SPI1_MOSI")):
            self.assertEqual(afs[pin, signal], {"GPIO_AF5_SPI1"})
        for pin, signal in (("PA2", "USART2_TX"), ("PA3", "USART2_RX")):
            self.assertEqual(afs[pin, signal], {"GPIO_AF7_USART2"})

    def test_old_acquisition_roles_and_drdy_polarity_rejected(self):
        rows = read_csv(ROOT / "Acquisition/pin_candidates.csv")
        old = [dict(row) for row in rows]
        next(row for row in old if row["role"] == "ADC_SCK").update(pin="PA5", package_position="21")
        with self.assertRaisesRegex(ValueError, "pin assignment mismatch"):
            validate_acquisition_assignment(old)
        path = ROOT / "Acquisition/SwiftThrust_Acquisition_Candidate/SwiftThrust_Acquisition_Candidate.ioc"
        for key, wrong in (("PA15.GPIO_ModeDefaultEXTI", "GPIO_MODE_IT_RISING"),
                            ("PA9.GPIO_PuPd", "GPIO_NOPULL"),
                            ("PA4.PinState", "GPIO_PIN_SET"),
                            ("NVIC.EXTI15_10_IRQn", "false\\:0"),
                            ("USART2.BaudRate", "9600")):
            values = read_ioc(path)
            values[key] = wrong
            with patch(__name__ + ".read_ioc", return_value=values):
                with self.assertRaises(ValueError):
                    validate_ioc("Acquisition", rows)

    def test_dma_plan_in_official_database(self):
        validate_dma(read_csv(ROOT / "Acquisition/dma_candidates.csv"), dma_db())

    def test_dma_stream_conflict_even_when_channel_differs(self):
        rows = read_csv(ROOT / "Acquisition/dma_candidates.csv")
        rows[1]["stream"], rows[1]["channel"] = rows[0]["stream"], "2"
        with self.assertRaises(ValueError):
            validate_dma(rows, dma_db())

    def test_dma_wrong_channel_rejected(self):
        rows = read_csv(ROOT / "Acquisition/dma_candidates.csv")
        rows[0]["channel"] = "0"
        with self.assertRaises(ValueError):
            validate_dma(rows, dma_db())

    def test_avdd_out_of_ads1220_range_rejected(self):
        self.assertFalse(adc_input_fits(2.2, 1, 1.1, 1.1, reference=2.2))
        self.assertTrue(adc_input_fits(2.5, 1, 1.25, 1.25, reference=2.5))

    def test_high_gain_bridge_common_mode_fails(self):
        self.assertFalse(adc_input_fits(5.0, 128, 0.305, 0.295))

    def test_5v_nominal_bridge_math_only(self):
        self.assertTrue(adc_input_fits(5.0, 128, 2.505, 2.495))

    def test_differential_full_scale_still_limits(self):
        self.assertFalse(adc_input_fits(5.0, 128, 2.52, 2.48))

    def test_excitation_direct_input_fails(self):
        self.assertFalse(adc_input_fits(5.0, 1, 5.0, 0.0))

    def test_bypass_gain_and_rail_limits(self):
        self.assertTrue(adc_input_fits(5.0, 1, 5.0, 0.0, bypass=True))
        self.assertFalse(adc_input_fits(5.0, 8, 2.505, 2.495, bypass=True))
        self.assertFalse(adc_input_fits(5.0, 1, 5.01, 0.0, bypass=True))

    def test_requested_rate_is_not_a_clock_selection(self):
        self.assertAlmostEqual(ordinary_rate(4096000, 2072), 1976.833976833977)
        self.assertAlmostEqual(2072 * 1e6 / 4096000, 505.859375)
        self.assertAlmostEqual((2072 + 114) * 1e6 / 4096000, 533.69140625)
        self.assertNotEqual(ordinary_rate(4096000, 2072), 2000)
        self.assertIsNone(ordinary_rate(None, None))

    def test_pending_values_not_silently_selected(self):
        config = json.loads((ROOT / "Models/config_pending.json").read_text(encoding="utf8"))
        self.assertIs(config["board_bound"], True)  # accepted target assignment, not a bench claim
        for field in ["bridge_sensitivity_mv_per_v", "sensor_wire_count", "divider_ratio_ch1", "regulator", "charger"]:
            self.assertIsNone(config["acquisition"][field], field)
        adc = config["acquisition"]
        self.assertEqual(adc["source"], "user_requested_pin_assignment")
        self.assertIs(adc["final_cad_match"], True)
        self.assertEqual(adc["final_cad_status"], "matched_schematic_and_PCB_PAD_NET_not_copper_or_bench_validation")
        sources = config["hardware_sources"]
        snapshot = json.loads((ROOT / sources["acquisition_final_snapshot"]).read_text(encoding="utf8"))
        comparison = json.loads((ROOT / sources["acquisition_final_comparison"]).read_text(encoding="utf8"))
        for evidence in (snapshot, comparison):
            self.assertEqual(adc["final_cad_source"], evidence["source"])
            self.assertEqual(adc["final_cad_sha256"], evidence["sha256"])
        self.assertEqual(comparison["status"], "MATCH")
        self.assertEqual(comparison["mismatches"], 0)
        self.assertEqual(adc["adc"], "ADS1220IPWR")
        self.assertEqual((adc["adc_clock_hz"], adc["adc_power_mode"], adc["channel_count"]),
                         (4096000, "turbo", 1))
        self.assertEqual((adc["osr"], adc["pga_ch0"], adc["pga_ch1"], adc["ch1_role"]),
                         (0, 1, 0, "absent"))
        self.assertAlmostEqual(adc["theoretical_rate_sps"],
                               ordinary_rate(adc["adc_clock_hz"], adc["conversion_cycles"]))
        self.assertIsNone(config["sampling_rate_validation_plan"]["measured_drdy_sps"])
        self.assertIsNone(config["sampling_rate_validation_plan"]["valid_record_sps"])
        profile = config["radio"]["active_profile"]
        self.assertEqual(profile["scope"], "ReferenceApp_only_not_hardware_verified")
        self.assertEqual((profile["frequency_hz"], profile["sf"], profile["bandwidth_hz"]),
                         (2473000000, 10, 812500))
        reference = config["reference_application"]
        self.assertIs(reference["hardware_tested"], False)
        self.assertIs(reference["physical_board_bound"], False)
        self.assertEqual(reference["adc"]["pga_ch0"], 1)

    def test_executable_reference_pinout_and_reserved_pins(self):
        all_rows = read_csv(ROOT / "Models/reference_pins.csv")
        for board, (_, filename, _) in PARTS.items():
            pins = pin_db(filename)
            rows = [dict(row) for row in all_rows if row["board"] == board]
            validate_pins(rows, pins)
            reserved = {row["pin"] for row in rows if row["signal"] == "RESERVED"}
            self.assertEqual(reserved, {"PC5", "PA11", "PA12"} if board == "Acquisition" else {"PA4"})
            if board == "Controller":
                uart = {row["role"]: row for row in rows if row["role"].startswith("DEBUG_UART")}
                self.assertEqual(uart["DEBUG_UART_TX"]["package_position"], "22")
                self.assertEqual(uart["DEBUG_UART_RX"]["package_position"], "23")

    def test_actual_cube_saved_pinout_matches_plan(self):
        for board in PARTS:
            validate_ioc(board, read_csv(ROOT / board / "pin_candidates.csv"))

    def test_controller_encoder_pa5_af_and_both_pin_tables(self):
        mapping = gpio_af_db("GPIO-STM32G07x_gpio_v1_0_Modes.xml")
        for pin, signal in (("PA5", "TIM2_CH1"), ("PA1", "TIM2_CH2")):
            self.assertEqual(mapping[pin, signal], {"GPIO_AF2_TIM2"})
        rows = [row for row in read_csv(ROOT / "Models/reference_pins.csv")
                if row["board"] == "Controller"]
        validate_ioc("Controller", rows)
        self.assertNotIn("PA0", {row["pin"] for row in rows})

    def test_controller_old_encoder_pin_and_filter_changes_rejected(self):
        path = ROOT / "Controller/SwiftThrust_Controller_Candidate/SwiftThrust_Controller_Candidate.ioc"
        rows = read_csv(ROOT / "Controller/pin_candidates.csv")
        for key, wrong in (("PA0.Signal", "S_TIM2_CH1_ETR"),
                           ("PA5.Signal", "SPI1_SCK"),
                           ("PA5.GPIO_PuPd", "GPIO_NOPULL"),
                           ("TIM2.EncoderMode", "TIM_ENCODERMODE_TI1"),
                           ("TIM2.Period", "4294967295"),
                           ("TIM2.IC1Filter", "0"), ("TIM2.IC2Filter", "0"),
                           ("RCC.APBFreq_Value", "8000000"),
                           ("ADC1.ClockPrescaler", "ADC_CLOCK_SYNC_PCLK_DIV1"),
                           ("ADC1.ScanConvMode", "ADC_SCAN_ENABLE")):
            with self.subTest(key=key):
                values = read_ioc(path)
                values[key] = wrong
                with patch(__name__ + ".read_ioc", return_value=values):
                    with self.assertRaises(ValueError):
                        validate_ioc("Controller", rows)
        old_rows = [dict(row) for row in rows]
        next(row for row in old_rows if row["role"] == "ENCODER_A").update(
            pin="PA0", package_position="7")
        values = read_ioc(path)
        for suffix in ("Signal", "GPIO_Label", "GPIO_PuPd"):
            values["PA0." + suffix] = values.pop("PA5." + suffix)
        with patch(__name__ + ".read_ioc", return_value=values):
            with self.assertRaises(ValueError):
                validate_ioc("Controller", old_rows)

    def test_old_clock_and_missing_remap_rejected(self):
        for board, key, wrong in (("Acquisition", "RCC.HSE_VALUE", "8000000"),
                                  ("Controller", "VP_SYS_VS_PINREMAP.Mode", "disabled")):
            values = read_ioc(ROOT / board / f"SwiftThrust_{board}_Candidate" /
                              f"SwiftThrust_{board}_Candidate.ioc")
            values[key] = wrong
            with patch(__name__ + ".read_ioc", return_value=values):
                with self.assertRaises(ValueError):
                    validate_ioc(board, read_csv(ROOT / board / "pin_candidates.csv"))

    def test_ignition_single_pulse_saved_in_cube(self):
        values = read_ioc(ROOT / "Acquisition/SwiftThrust_Acquisition_Candidate/SwiftThrust_Acquisition_Candidate.ioc")
        self.assertEqual(values["TIM2.Prescaler"], "95")
        self.assertEqual(values["TIM2.Period"], "1000000") # 1us low guard +1s autonomous high
        self.assertEqual(values["TIM2.Pulse"], "1")
        self.assertEqual(values["TIM2.OCMode_PWM"], "TIM_OCMODE_PWM2")
        self.assertEqual(values["VP_TIM2_VS_OPM.Mode"], "OPM_bit")
        self.assertEqual(values["ADC1.SamplingTime-0\\#ChannelRegularConversion"], "ADC_SAMPLETIME_480CYCLES")

    def test_r8_link_led_is_free_gpio_and_saved_low(self):
        for board, (_, filename, _) in PARTS.items():
            rows=read_csv(ROOT/board/'pin_candidates.csv')
            led=[r for r in rows if r['role']=='LINK_LED']
            self.assertEqual(len(led),1)
            expected_pin = 'PB10' if board == 'Acquisition' else 'PB0'
            self.assertEqual(led[0]['pin'],expected_pin)
            self.assertEqual(led[0]['signal'],'GPIO_Output')
            validate_pins(rows,pin_db(filename))
            values=read_ioc(ROOT/board/f'SwiftThrust_{board}_Candidate'/f'SwiftThrust_{board}_Candidate.ioc')
            self.assertEqual(values[expected_pin+'.PinState'],'GPIO_PIN_RESET')

    def test_analog_cad_contract_stays_physically_unverified(self):
        config = json.loads((ROOT / "Models/config_pending.json").read_text(encoding="utf8"))
        candidate = config["hardware_candidate"]
        self.assertEqual(candidate["status"], "20261101_acquisition_user_pin_assignment_final_CAD_matched_controller_20261029_CAD")
        self.assertEqual(candidate["controller_exact_part"], "STM32G071KBT6")
        self.assertTrue(adc_input_fits(candidate["adc_avdd_v"], 128, candidate["bridge_excitation_v"] / 2 + 0.0025, candidate["bridge_excitation_v"] / 2 - 0.0025))
        self.assertIs(config["board_bound"], True)
        self.assertIs(config["reference_application"]["hardware_tested"], False)
        self.assertIs(config["reference_application"]["cad_contract_bound"], True)
        self.assertEqual(candidate["adc_reference_v"], candidate["bridge_excitation_v"])
        self.assertEqual(config["acquisition"]["pga_ch0"], 1)
        self.assertTrue(config["reference_application"]["adc"]["default_pga_bypass"])
        self.assertEqual(config["acquisition"]["ch1_role"], "absent")

    def test_candidate_tolerance_budget_example(self):
        # Math-only 5% supply budget; not a claim about chosen regulators/sensors.
        for avdd in (4.75, 5.0, 5.25):
            excitation = avdd
            half_differential = excitation * 0.002 / 2  # example 2mV/V bridge
            self.assertTrue(adc_input_fits(avdd, 128, excitation / 2 + half_differential,
                                           excitation / 2 - half_differential, reference=avdd))
            self.assertFalse(adc_input_fits(avdd, 128, 0.25 + half_differential,
                                            0.25 - half_differential, reference=avdd))

    def test_replaceable_sensor_profile_does_not_claim_auto_identification(self):
        config = json.loads((ROOT / "Models/config_pending.json").read_text(encoding="utf8"))
        requirement = config["sensor_calibration_requirements"]
        self.assertIn("do_not_guess", requirement["automatic_identification"])
        self.assertIs(requirement["static_calibration_proves_dynamic_bandwidth"], False)
        for field in ["force_unit", "rated_sensitivity_mV_per_V", "actual_excitation_V", "zero_raw", "calibration_coefficients", "calibration_time", "calibration_validity"]:
            self.assertIn(field, requirement["profile_fields"])

    def test_voltage_leds_cad_binding_and_oled_exact_module(self):
        config = json.loads((ROOT / "Models/config_pending.json").read_text(encoding="utf8"))
        leds = config["acquisition"]["voltage_leds"]
        self.assertEqual(leds["count"], 4)
        self.assertEqual(leds["thresholds_mv"], [3480, 3630, 3840])
        self.assertIs(leds["physical_output_enabled"], True)
        self.assertIs(leds["precise_SOC_claim"], False)
        rows = [row for row in read_csv(ROOT / "Acquisition/pin_candidates.csv") if row["role"].startswith("LED_VOLT_")]
        self.assertEqual([row["pin"] for row in rows], leds["pins_candidate"])
        self.assertTrue(all(row["signal"] == "GPIO_Output" for row in rows))
        display = config["controller"]["display"]
        self.assertEqual((display["layout_width"], display["layout_height"]), (128, 64))
        self.assertEqual(display["diagonal_inches"], 1.3)
        self.assertEqual(display["controller"], "SSD1306")
        self.assertIn("Common SSD1306", display["module"])
        self.assertEqual(display["address_7bit"], 0x3C)
        self.assertIs(display["hardware_verified"], False)
        self.assertEqual(config["controller"]["sram_budget_kib"], 32)
        self.assertEqual(config["controller"]["battery_pin"], "PA3")
        self.assertEqual(config["controller"]["battery_divider_ratio"], 2)

    def test_bsp_host_syntax_and_target_rejection(self):
        for board, header in [("Acquisition", "st_bsp.h"), ("Controller", "st_controller_bsp.h")]:
            command = [os.environ.get("HOST_CC","gcc"), "-std=c11", "-Wall", "-Wextra", "-Werror", "-pedantic", "-x", "c", "-fsyntax-only", "-include", str(ROOT / board / "include" / header), "-"]
            source = b"int main(void) { return 0; }\n"
            host = subprocess.run(command, input=source, capture_output=True, timeout=10)
            self.assertEqual(host.returncode, 0, host.stderr.decode(errors="replace"))
            target = subprocess.run(command[:1] + ["-DST_TARGET_BUILD"] + command[1:], input=source, capture_output=True, timeout=10)
            self.assertNotEqual(target.returncode, 0)
            self.assertIn(b"UNBOUND", target.stderr)
            arm_marker = subprocess.run(command[:1] + ["-D__arm__"] + command[1:], input=source, capture_output=True, timeout=10)
            self.assertNotEqual(arm_marker.returncode, 0)
            self.assertIn(b"UNBOUND", arm_marker.stderr)


if __name__ == "__main__":
    sys.stdout.reconfigure(encoding="utf-8")
    stream = io.StringIO()
    result = unittest.TextTestRunner(stream=stream, verbosity=2).run(unittest.defaultTestLoader.loadTestsFromTestCase(Regression))
    text = stream.getvalue()
    print(text)
    raise SystemExit(0 if result.wasSuccessful() else 1)
