aleistercrowleybeast666/SwiftTrust/Acquisition/ports/st_ignition_f4.h

#ifndef __ST_IGNITION_F4_H
#define __ST_IGNITION_F4_H
#include "st_ignition.h"
/* PA0 (LQFP64 pin 14), AF1 TIM2_CH1. One-shot duration from shared config. */
IgnitionOutputResult IgnitionPulse_Init(void);
IgnitionOutputResult IgnitionPulse_Start(void *);
IgnitionOutputResult IgnitionPulse_Stop(void *);
bool IgnitionPulse_IsRunning(void *);
/* NMI-safe permanent cutoff. Only a hardware reset can restore authorization. */
void IgnitionPulse_FaultIsr(void);
#endif
