aleistercrowleybeast666/SwiftTrust/Acquisition/include/st_auto_link.h

#ifndef __ST_AUTO_LINK_H
#define __ST_AUTO_LINK_H
#include "st_pairing.h"
enum
{
    AUTO_LINK_DISCOVER = ST2_DISCOVER,
    AUTO_LINK_ADVERTISE = ST2_ADVERTISE,
    AUTO_LINK_BYTES = 46
};
typedef struct
{
    st_pairing *pairing;
    void *ctx;
    bool (*idle)(void *);
    uint8_t key[16];
    uint32_t network;
    uint32_t last_send_ms;
    bool sent, changed;
} AutoLink;
void AutoLink_Init(AutoLink *, st_pairing *, const uint8_t key[16], uint32_t network, void *,
                   bool (*idle)(void *));
bool AutoLink_TxDue(AutoLink *, uint32_t now_ms, uint8_t out[ST2_MAX], size_t *);
size_t AutoLink_Receive(AutoLink *, const uint8_t *, size_t, uint8_t out[ST2_MAX]);
bool AutoLink_TakeChanged(AutoLink *);
#endif
