aleistercrowleybeast666/SwiftTrust/(commit log)

2026-10-20 Add non-ignition acquisition components and dual EIDE link-check projects
    Include STLOG001 logging, compact wireless transactions, four-page OLED UI, independent debug UART adapters, and explicit integration handoff. Host: 27 groups / 21469 assertions; both ARM component targets linked. Hardware and operational board integration remain unverified.
    [dma_candidates.csv, pin_candidates.csv]
2026-10-20 Add guarded HAL storage adapters and durable link journal core
    Replace link-only diskio with real FatFs bridge and bounded aligned sector I/O. Add ADS/SX128x/SDIO HAL adapters and a two-slot link-identity journal without choosing Flash addresses. Validate the actual FatFs worker/logger on synthetic RAM FAT16 and all97 journal write-cut positions. Host32 groups/33482 assertions; both ARM component targets link. Board startup, physical NV backend and hardware validation remain pending.
    [link_check_main.c, run_host_tests.py, st_ads_hal.c, st_ads_hal.h, st_block.c, st_block.h, st_diskio.c]
2026-10-20 Add transactional load calibration and encoder-only reference input
    Support tare windows, known g/kg/N references and mass presets, fixed-point digit editing with monochrome inverse selection, binding validation, and save-before-activation rollback behavior. Preserve original ADC records and STLOG001 layout. Host37 groups/35988 assertions and both ARM component targets pass. Physical parameter storage, sample tap and calibration RPC remain unbound; ignition pages stay static.
    [link_check_main.c, run_host_tests.py, st_cal.c, st_cal.h, st_cal_service.c, st_cal_service.h, st_cal_ui.c]
2026-10-20 Integrate non-ignition calibration ADC tap, TF persistence and compact RPC
    Route readonly DMA captures through a bounded calibration queue; bind a real FatFs dual-file store with sync, seal, close, readback and startup reconciliation. Add epoch-scoped 23-byte commands and four bounded view fragments with idempotent SAVE, START exclusion and truthful uncertain-result UI.
    Validate 43 host groups / 40371 assertions including real FatFs synthetic-card end-to-end and sector fault injection. Both actual EIDE targets retain calibration and DMA callback symbols and link. Full board initialization, physical link NV backend and all hardware tests remain pending; ignition execution remains absent.
2026-10-20 Close non-ignition radio runtime wiring and document board dependencies
    Retain produced replies under RF backpressure, anchor retries to actual TX_DONE/timeout, and cancel superseded or expired unsent requests before the next radio tick. Keep explicit connect/START semantics and no automatic replay after radio fault.
    Focused RF-event regression passes 6 groups/313 assertions; both actual EIDE targets retain runtime entry points and link. The prior 43-group calibration suite is preserved as an e6589b0 baseline rather than rerun. Document four minimal external hardware input groups and remaining board initialization; no hardware settings or ignition chain are added.
2026-10-20 Complete non-ignition reference-board applications and persistence
    [reference_pins.csv]
2026-10-21 Add remote ignition signal, automatic LoRa link, and battery indication
    [pin_candidates.csv, reference_pins.csv]
2026-10-21 Refactor R8 menus, resumable transactions and shared configuration
    Unify four-row bilingual task menus and R8 framing, retain ADC/FatFs/raw logs and permanent calibration, isolate session zero, and keep real output disabled pending review. Include offline regressions, CubeMX resource checks and complete protocol documentation.
    [pin_candidates.csv, reference_pins.csv]
2026-10-23 Enable acquisition HSE, battery indication and one-second resistive output
2026-10-23 Fix lowercase z glyph and cover ADC diagnostic rendering
    [st_raster.c, test_r2.c]
2026-10-28 Adapt R8 firmware to ADS1220 and October 2026 boards
    [pin_candidates.csv, reference_pins.csv]
2026-11-01 Remap acquisition GPIO and debug UART to final November PCB
    [pin_candidates.csv, reference_pins.csv]
2026-11-07 Verify completed acquisition PCB before main merge
2026-11-07 Move controller encoder channel A to PA5
    [pin_candidates.csv, reference_pins.csv]
